giuliovignati/headphone_amplifier/headphone_amplifier board/Headphone_Amp.kicad_pcb

## KiCad design headphone_amplifier board/Headphone_Amp.kicad_pcb (2025-02-23)

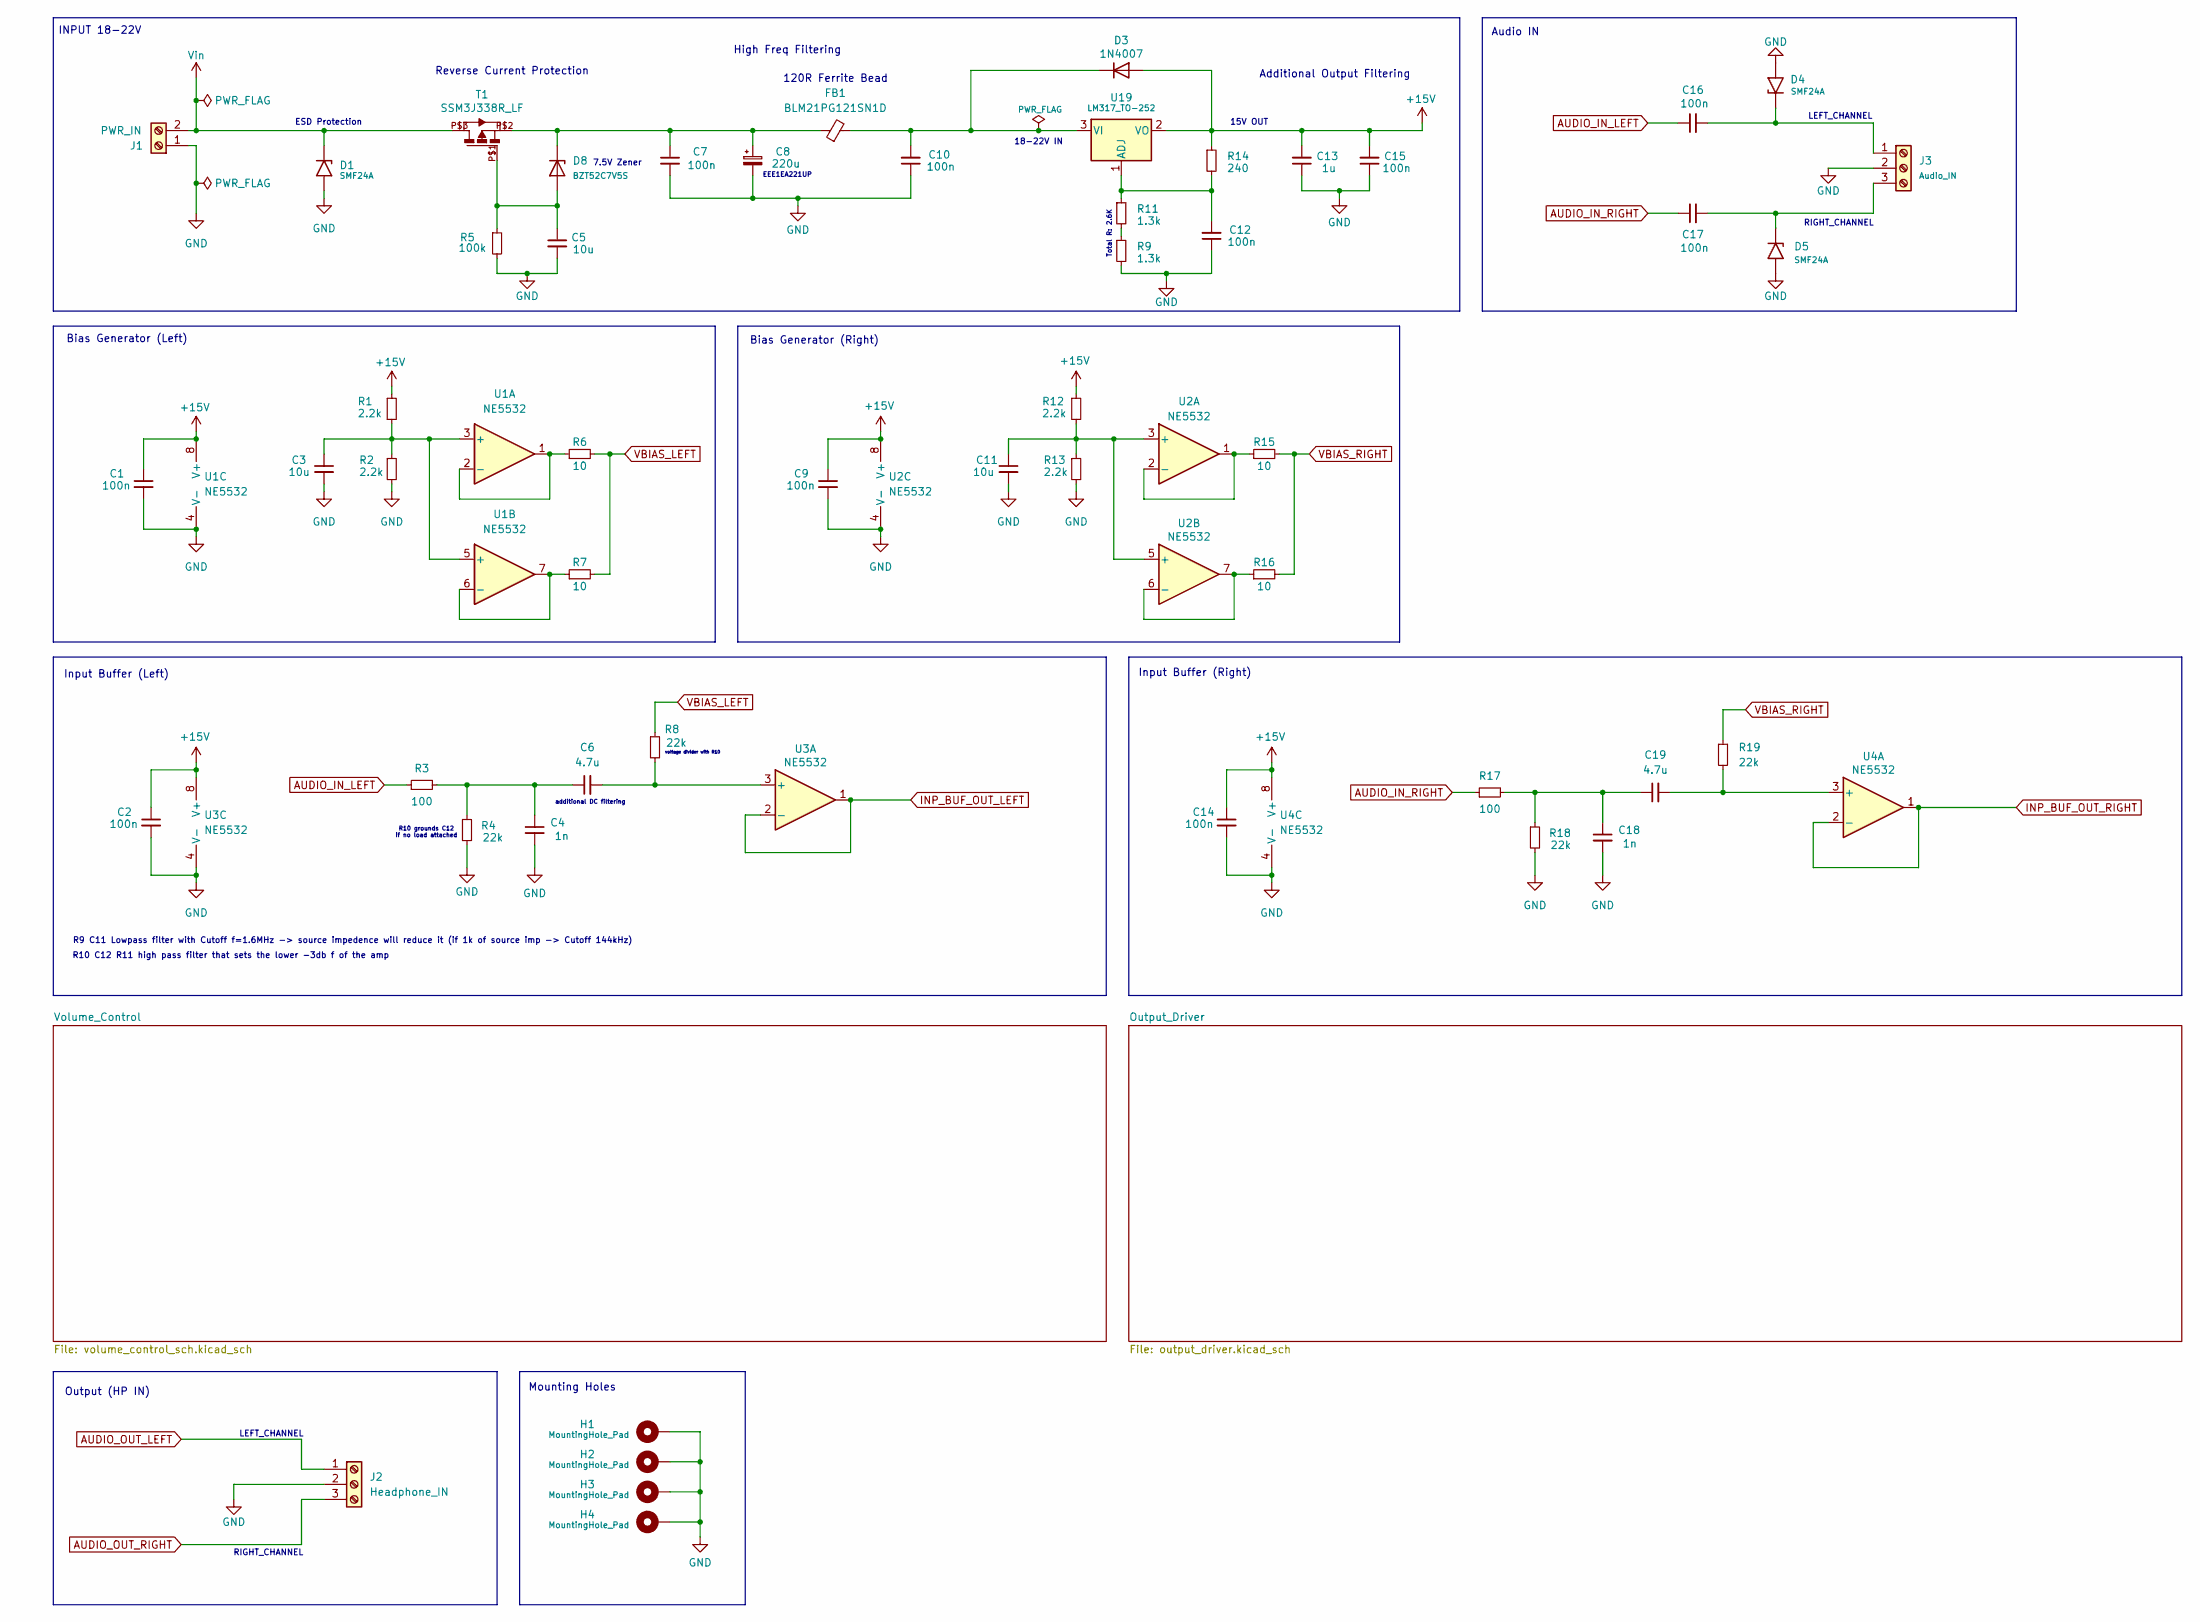
[picture p1: schematic Headphone_Amp.kicad_sch, Headphone Amplifier]

Parts:
C1, C2, C7, C9, C10, C12, C14, C15, C16, C17: 100n; C_0805_2012Metric_Pad1.18x1.45mm_HandSolder
C3, C5, C11: 10u; C_0805_2012Metric_Pad1.18x1.45mm_HandSolder
C4, C18: 1n; C_0805_2012Metric_Pad1.18x1.45mm_HandSolder
C6, C19: 4.7u; C_0805_2012Metric_Pad1.18x1.45mm_HandSolder
C8: 220u; EEE1EA221UP
C13: 1u; C_0805_2012Metric_Pad1.18x1.45mm_HandSolder
D1, D4, D5: SMF24A; D_SOD-123
D3: 1N4007; D_SMA
D8: BZT52C7V5S; D_SOD-123F
FB1: BLM21PG121SN1D; C_0805_2012Metric_Pad1.18x1.45mm_HandSolder
H1, H2, H3, H4: MountingHole_Pad; MountingHole_3.2mm_M3_Pad_Via
J1: PWR_IN; TerminalBlock_bornier-2_P5.08mm
J2: Headphone_IN; TerminalBlock_bornier-3_P5.08mm
J3: Audio_IN; TerminalBlock_bornier-3_P5.08mm
R1, R2, R12, R13: 2.2k; R_0805_2012Metric_Pad1.20x1.40mm_HandSolder
R3, R17: 100; R_0805_2012Metric_Pad1.20x1.40mm_HandSolder
R4, R8, R18, R19: 22k; R_0805_2012Metric_Pad1.20x1.40mm_HandSolder
R5: 100k; R_0805_2012Metric_Pad1.20x1.40mm_HandSolder
R6, R7, R15, R16: 10; R_0805_2012Metric_Pad1.20x1.40mm_HandSolder
R9, R11: 1.3k; R_0805_2012Metric_Pad1.20x1.40mm_HandSolder
R14: 240; R_0805_2012Metric_Pad1.20x1.40mm_HandSolder
T1: SSM3J338R_LF
U1, U2, U3, U4: NE5532; SOIC-8_3.9x4.9mm_P1.27mm
U19: LM317_TO-252; SOT-223

Connections:
+15V: C1.1, C2.1, C9.1, C13.2, C14.1, C15.2, D3.2 (A), R1.1, R12.1, R14.1, U1.8 (V+), U2.8 (V+), U3.8 (V+), U4.8 (V+), U19.2 (VO); also elsewhere on the board
AUDIO_IN_LEFT: C16.1, R3.1
AUDIO_IN_RIGHT: C17.1, R17.1
AUDIO_OUT_LEFT: J2.1; also elsewhere on the board
AUDIO_OUT_RIGHT: J2.3; also elsewhere on the board
GND: C1.2, C2.2, C3.2, C4.2, C5.2, C7.2, C8.2, C9.2, C10.1, C11.2, C12.1, C13.1, C14.2, C15.1, C18.2, D1.2 (A2), D4.2 (A2), D5.2 (A2), H1.1, H2.1, H3.1, H4.1, J1.1, J2.2, J3.2, R2.2, R4.2, R5.2, R9.2, R13.2, R18.2, U1.4 (V-), U2.4 (V-), U3.4 (V-), U4.4 (V-); also elsewhere on the board
INP_BUF_OUT_LEFT: U3.1, U3.2 (-); also elsewhere on the board
INP_BUF_OUT_RIGHT: U4.1, U4.2 (-); also elsewhere on the board
unnamed: C4.1, C6.1, R3.2, R4.1
unnamed: C18.1, C19.1, R17.2, R18.1
unnamed: C10.2, D3.1 (K), FB1.2, U19.3 (VI)
unnamed: C16.2, D4.1 (A1), J3.1
unnamed: C17.2, D5.1 (A1), J3.3
unnamed: C5.1, D8.2 (A), R5.1, T1.P$1
unnamed: C7.1, C8.1, D8.1 (K), FB1.1, T1.P$2
unnamed: R9.1, R11.2
unnamed: C3.1, R1.2, R2.1, U1.3 (+), U1.5 (+)
unnamed: R6.1, U1.1, U1.2 (-)
unnamed: R7.1, U1.6 (-), U1.7
unnamed: C11.1, R12.2, R13.1, U2.3 (+), U2.5 (+)
unnamed: R15.1, U2.1, U2.2 (-)
unnamed: R16.1, U2.6 (-), U2.7
unnamed: C6.2, R8.2, U3.3 (+)
unnamed: C19.2, R19.2, U4.3 (+)
unnamed: C12.2, R11.1, R14.2, U19.1 (ADJ)
VBIAS_LEFT: R6.2, R7.2, R8.1; also elsewhere on the board
VBIAS_RIGHT: R15.2, R16.2, R19.1; also elsewhere on the board
Vin: D1.1 (A1), J1.2, T1.P$3

Notes on the sheet:
Audio IN
120R Ferrite Bead
15V OUT
ESD Protection
7.5V Zener
R10 C12 R11 high pass filter that sets the lower -3db f of the amp
Total R: 2.6K
Bias Generator (Right)
Mounting Holes
Input Buffer (Right)
High Freq Filtering
Output (HP IN)
EEE1EA221UP
Reverse Current Protection
RIGHT_CHANNEL
Bias Generator (Left)
LEFT_CHANNEL
INPUT 18-22V
R10 grounds C12 if no load attached
18-22V IN
Additional Output Filtering
R9 C11 Lowpass filter with Cutoff f=1.6MHz -> source impedence will reduce it (if 1k of source imp -> Cutoff 144kHz)
Input Buffer (Left)
voltage divider with R10
additional DC filtering

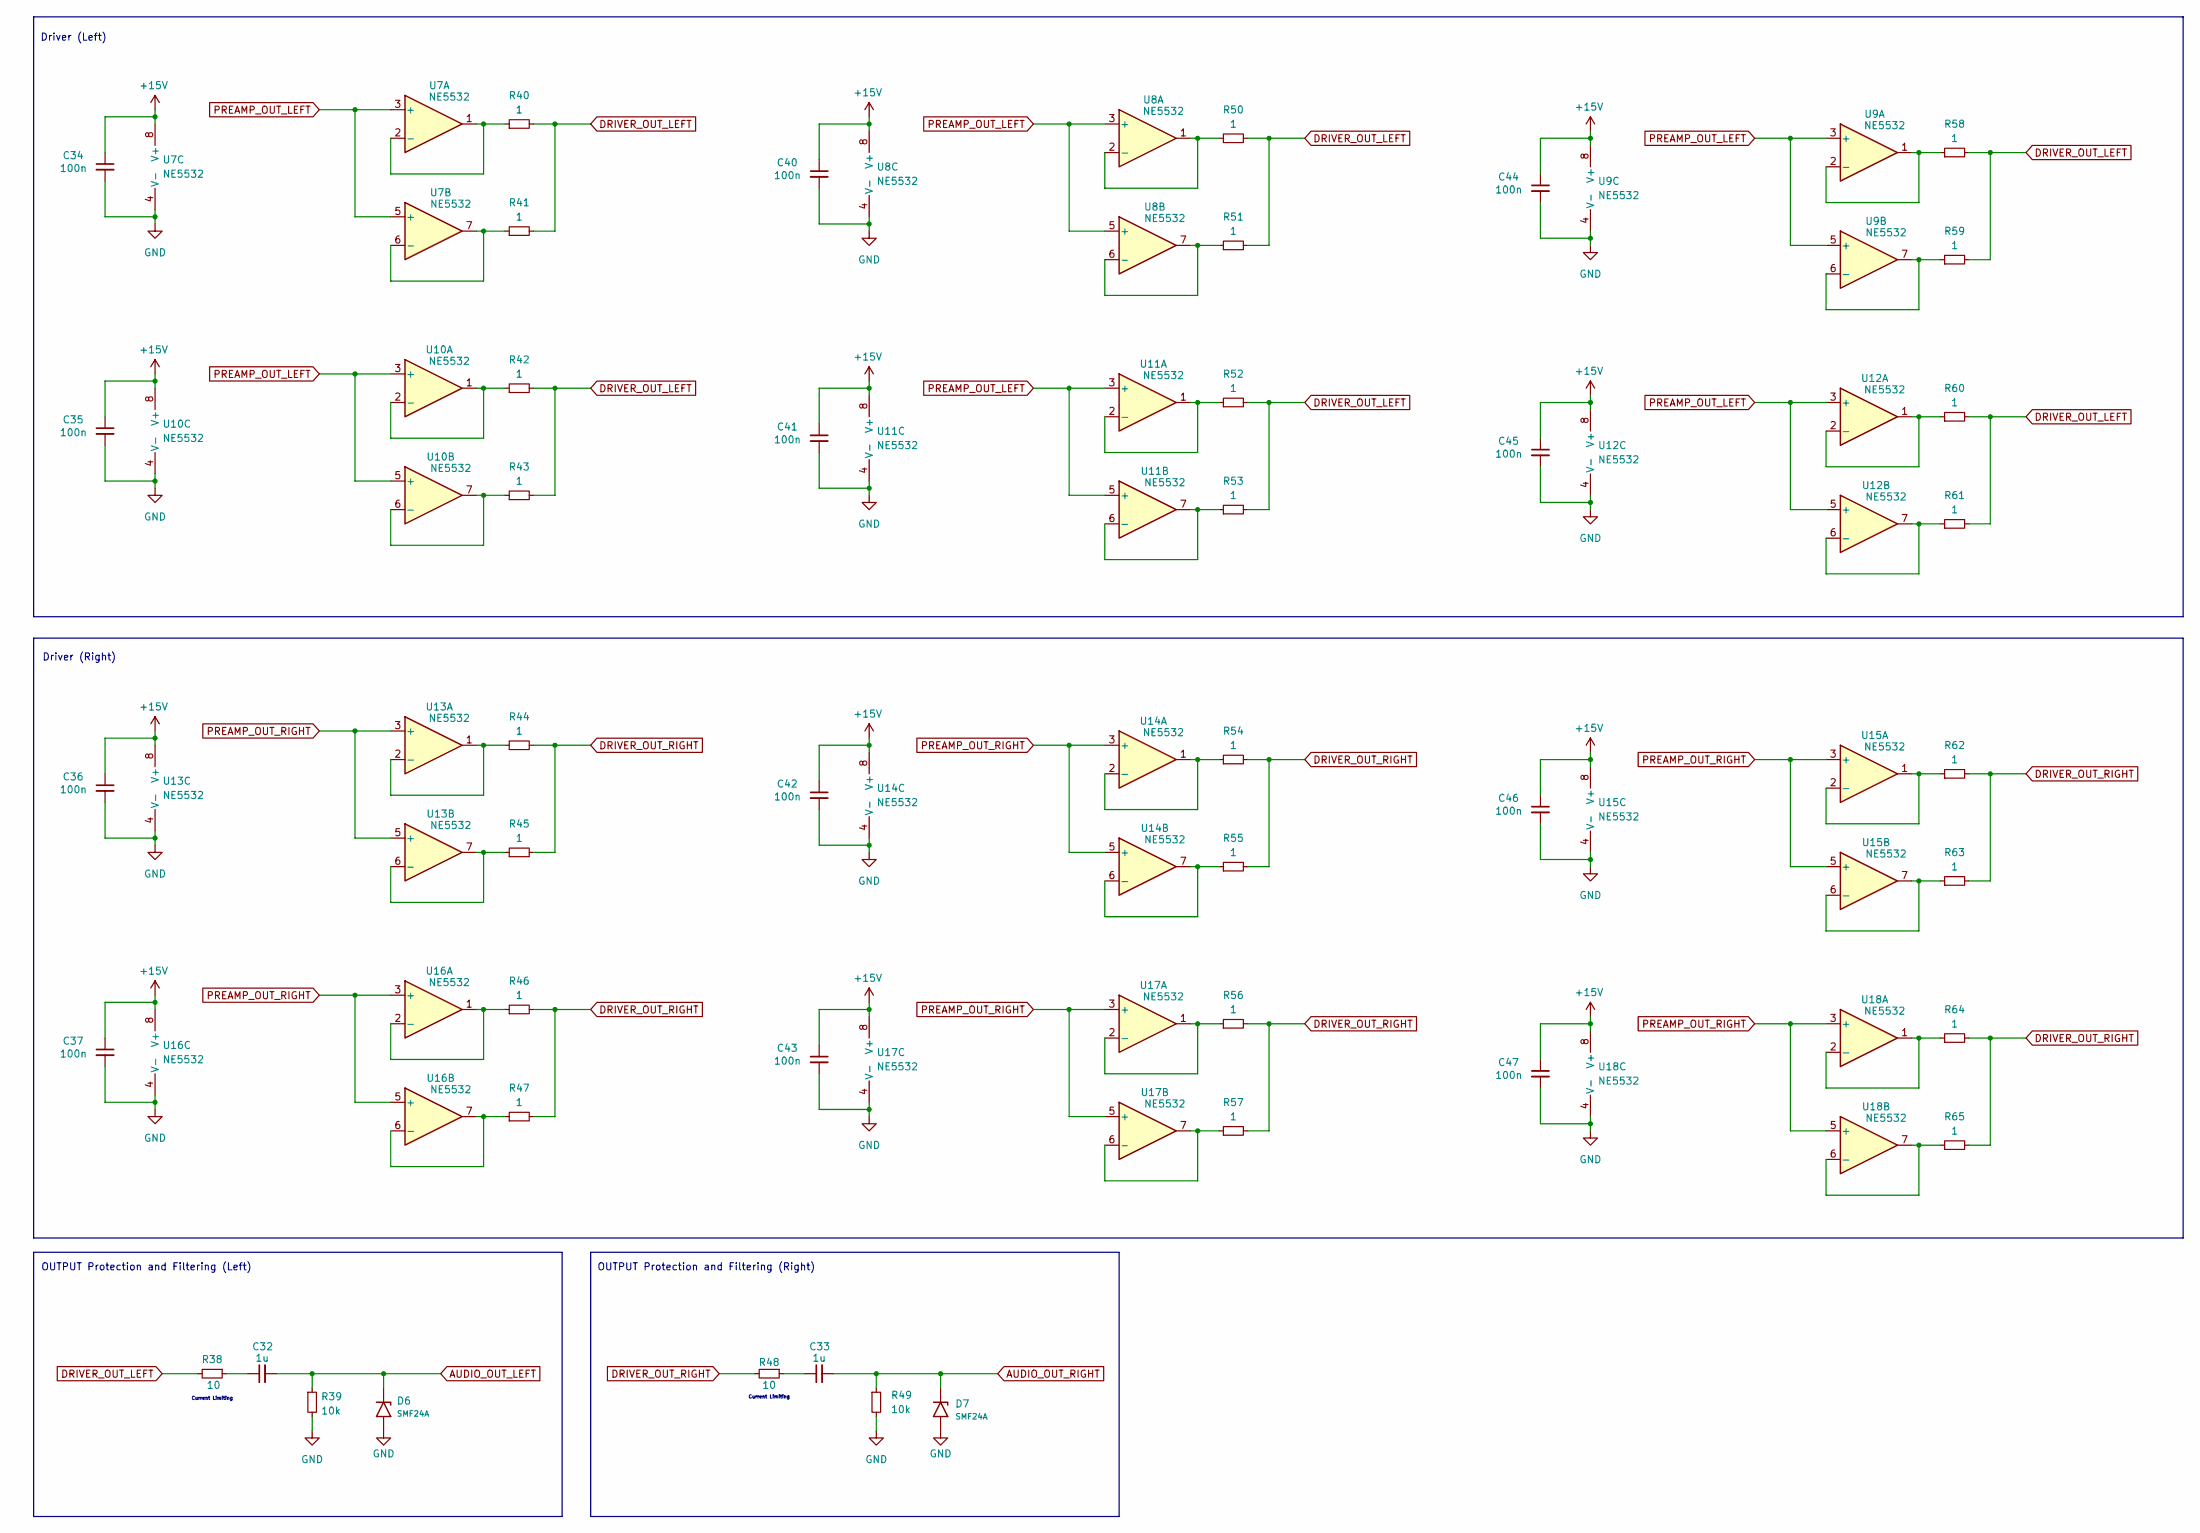
[picture p2: schematic output_driver.kicad_sch, Output Driver Stage]

Parts:
C32, C33: 1u; C_Rect_L18.0mm_W7.0mm_P15.00mm_FKS3_FKP3
C34, C35, C36, C37, C40, C41, C42, C43, C44, C45, C46, C47: 100n; C_0805_2012Metric_Pad1.18x1.45mm_HandSolder
D6, D7: SMF24A; D_SOD-123
R38, R48: 10; R_0805_2012Metric_Pad1.20x1.40mm_HandSolder
R39, R49: 10k; R_0805_2012Metric_Pad1.20x1.40mm_HandSolder
R40, R41, R42, R43, R44, R45, R46, R47, R50, R51, R52, R53, R54, R55, R56, R57, R58, R59, R60, R61, R62, R63, R64, R65: 1; R_0805_2012Metric_Pad1.20x1.40mm_HandSolder
U7, U8, U9, U10, U11, U12, U13, U14, U15, U16, U17, U18: NE5532; SOIC-8_3.9x4.9mm_P1.27mm

Connections:
+15V: C34.1, C35.1, C36.1, C37.1, C40.1, C41.1, C42.1, C43.1, C44.1, C45.1, C46.1, C47.1, U7.8 (V+), U8.8 (V+), U9.8 (V+), U10.8 (V+), U11.8 (V+), U12.8 (V+), U13.8 (V+), U14.8 (V+), U15.8 (V+), U16.8 (V+), U17.8 (V+), U18.8 (V+); also elsewhere on the board
AUDIO_OUT_LEFT: C32.2, D6.1 (A1), R39.1; also elsewhere on the board
AUDIO_OUT_RIGHT: C33.2, D7.1 (A1), R49.1; also elsewhere on the board
DRIVER_OUT_LEFT: R38.2, R40.2, R41.2, R42.2, R43.2, R50.2, R51.2, R52.2, R53.2, R58.2, R59.2, R60.2, R61.2
DRIVER_OUT_RIGHT: R44.2, R45.2, R46.2, R47.2, R48.2, R54.2, R55.2, R56.2, R57.2, R62.2, R63.2, R64.2, R65.2
GND: C34.2, C35.2, C36.2, C37.2, C40.2, C41.2, C42.2, C43.2, C44.2, C45.2, C46.2, C47.2, D6.2 (A2), D7.2 (A2), R39.2, R49.2, U7.4 (V-), U8.4 (V-), U9.4 (V-), U10.4 (V-), U11.4 (V-), U12.4 (V-), U13.4 (V-), U14.4 (V-), U15.4 (V-), U16.4 (V-), U17.4 (V-), U18.4 (V-); also elsewhere on the board
unnamed: C32.1, R38.1
unnamed: C33.1, R48.1
unnamed: R40.1, U7.1, U7.2 (-)
unnamed: R41.1, U7.6 (-), U7.7
unnamed: R50.1, U8.1, U8.2 (-)
unnamed: R51.1, U8.6 (-), U8.7
unnamed: R58.1, U9.1, U9.2 (-)
unnamed: R59.1, U9.6 (-), U9.7
unnamed: R42.1, U10.1, U10.2 (-)
unnamed: R43.1, U10.6 (-), U10.7
unnamed: R52.1, U11.1, U11.2 (-)
unnamed: R53.1, U11.6 (-), U11.7
unnamed: R60.1, U12.1, U12.2 (-)
unnamed: R61.1, U12.6 (-), U12.7
unnamed: R44.1, U13.1, U13.2 (-)
unnamed: R45.1, U13.6 (-), U13.7
unnamed: R54.1, U14.1, U14.2 (-)
unnamed: R55.1, U14.6 (-), U14.7
unnamed: R62.1, U15.1, U15.2 (-)
unnamed: R63.1, U15.6 (-), U15.7
unnamed: R46.1, U16.1, U16.2 (-)
unnamed: R47.1, U16.6 (-), U16.7
unnamed: R56.1, U17.1, U17.2 (-)
unnamed: R57.1, U17.6 (-), U17.7
unnamed: R64.1, U18.1, U18.2 (-)
unnamed: R65.1, U18.6 (-), U18.7
PREAMP_OUT_LEFT: U7.3 (+), U7.5 (+), U8.3 (+), U8.5 (+), U9.3 (+), U9.5 (+), U10.3 (+), U10.5 (+), U11.3 (+), U11.5 (+), U12.3 (+), U12.5 (+); also elsewhere on the board
PREAMP_OUT_RIGHT: U13.3 (+), U13.5 (+), U14.3 (+), U14.5 (+), U15.3 (+), U15.5 (+), U16.3 (+), U16.5 (+), U17.3 (+), U17.5 (+), U18.3 (+), U18.5 (+); also elsewhere on the board

Notes on the sheet:
Driver (Left)
Current Limiting
Driver (Right)
OUTPUT Protection and Filtering (Right)
OUTPUT Protection and Filtering (Left)

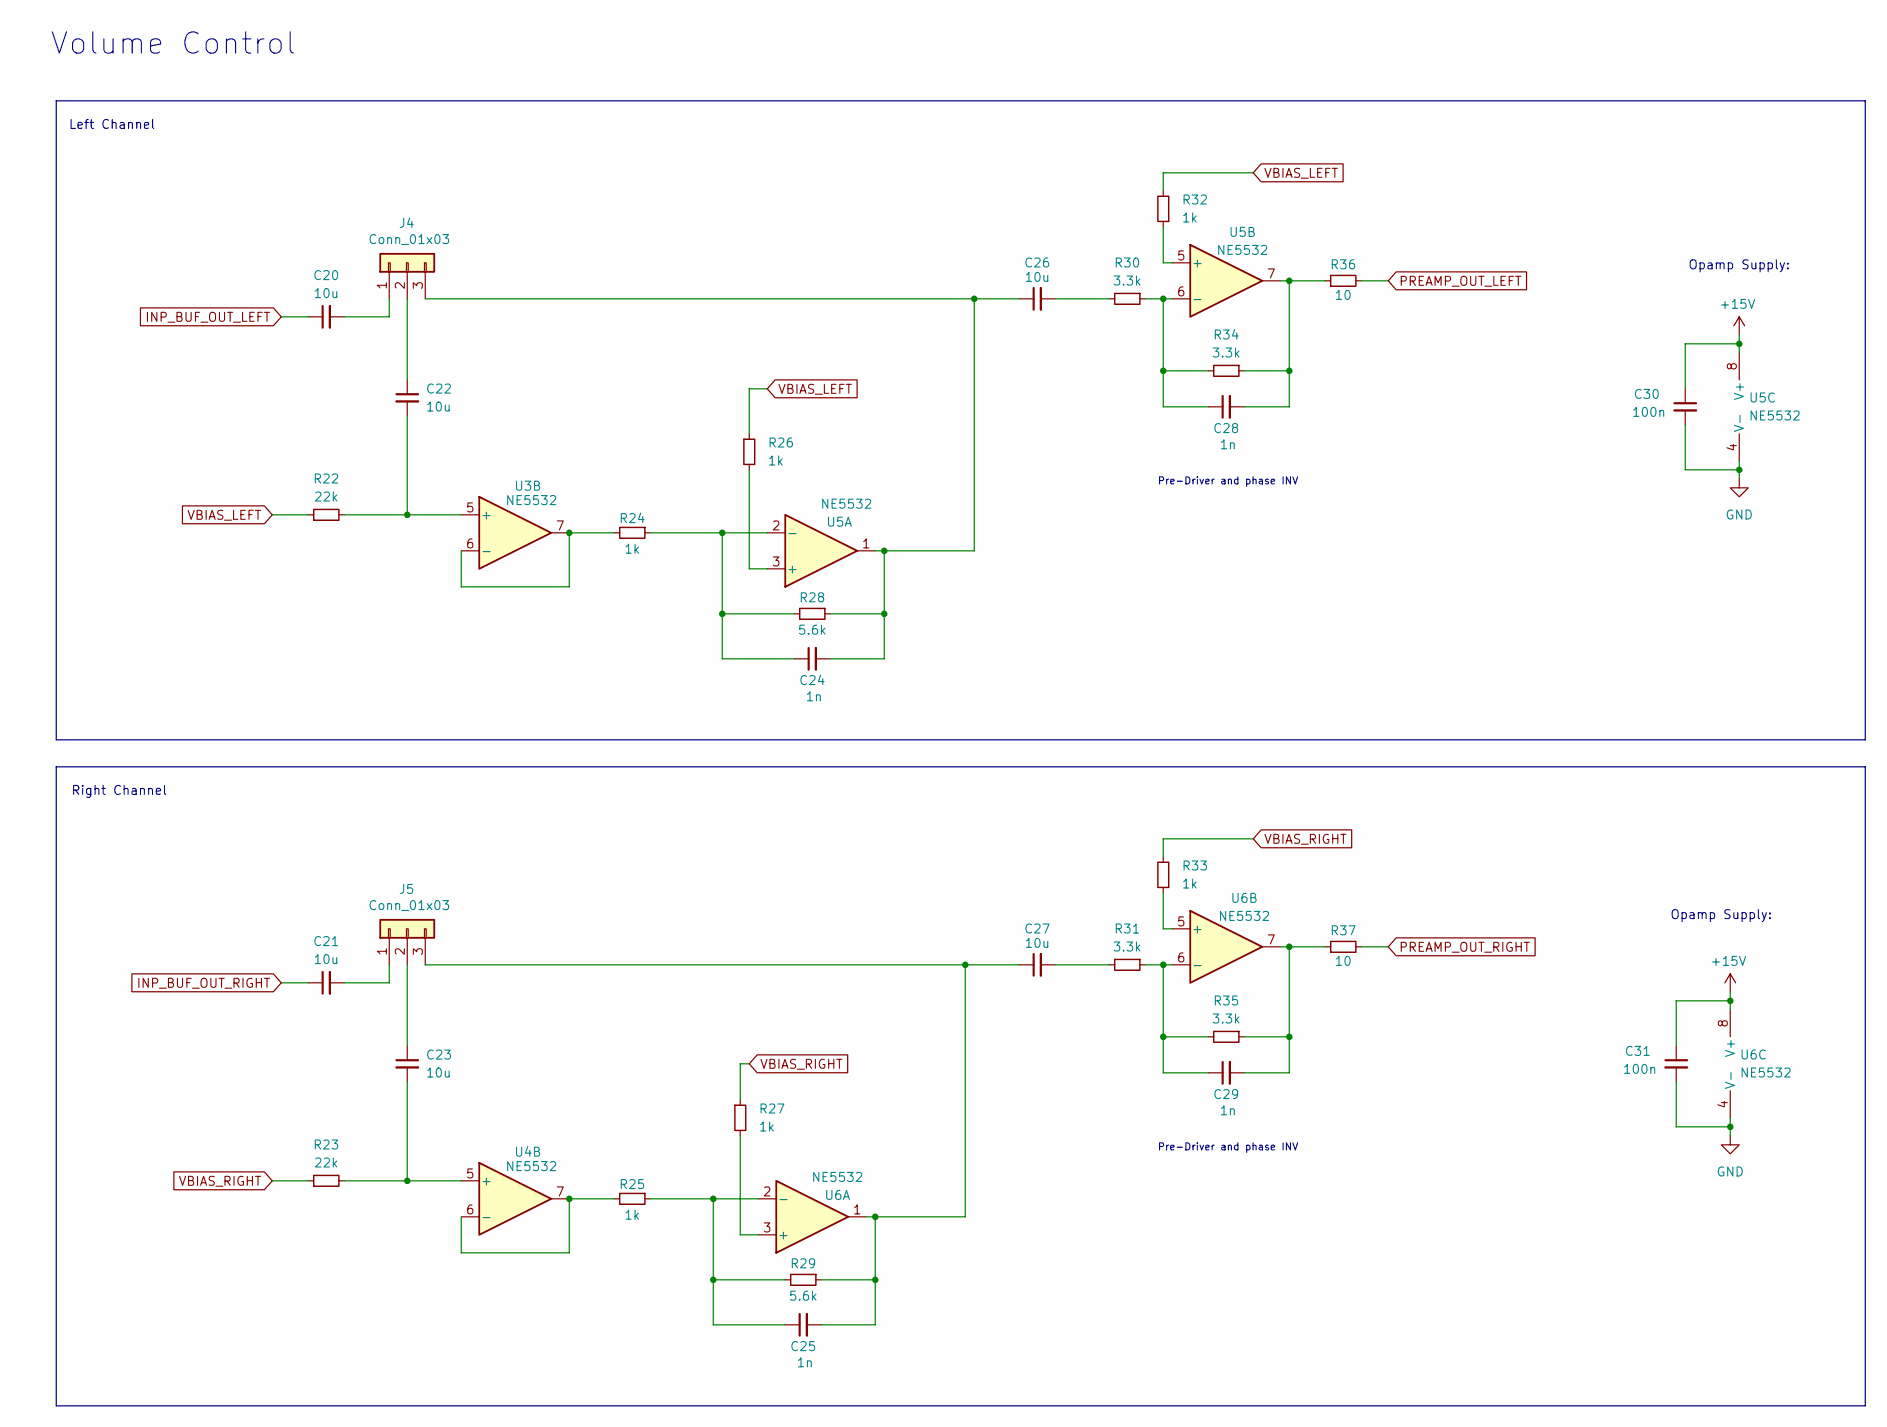
[picture p3: schematic volume_control_sch.kicad_sch, Baxandaal Volume Control Stage]

Parts:
C20, C21, C22, C23, C26, C27: 10u; C_0805_2012Metric_Pad1.18x1.45mm_HandSolder
C24, C25, C28, C29: 1n; C_0805_2012Metric_Pad1.18x1.45mm_HandSolder
C30, C31: 100n; C_0805_2012Metric_Pad1.18x1.45mm_HandSolder
J4, J5: Conn_01x03; PinHeader_1x03_P2.54mm_Vertical
R22, R23: 22k; R_0805_2012Metric_Pad1.20x1.40mm_HandSolder
R24, R25, R26, R27, R32, R33: 1k; R_0805_2012Metric_Pad1.20x1.40mm_HandSolder
R28, R29: 5.6k; R_0805_2012Metric_Pad1.20x1.40mm_HandSolder
R30, R31, R34, R35: 3.3k; R_0805_2012Metric_Pad1.20x1.40mm_HandSolder
R36, R37: 10; R_0805_2012Metric_Pad1.20x1.40mm_HandSolder
U3, U4, U5, U6: NE5532; SOIC-8_3.9x4.9mm_P1.27mm

Connections:
+15V: C30.1, C31.1, U5.8 (V+), U6.8 (V+); also elsewhere on the board
GND: C30.2, C31.2, U5.4 (V-), U6.4 (V-); also elsewhere on the board
INP_BUF_OUT_LEFT: C20.1; also elsewhere on the board
INP_BUF_OUT_RIGHT: C21.1; also elsewhere on the board
unnamed: C26.2, R30.2
unnamed: C27.2, R31.2
unnamed: C28.2, R34.1, R36.1, U5.7
unnamed: C29.2, R35.1, R37.1, U6.7
unnamed: C20.2, J4.1
unnamed: C22.1, J4.2
unnamed: C24.2, C26.1, J4.3, R28.1, U5.1
unnamed: C21.2, J5.1
unnamed: C23.1, J5.2
unnamed: C25.2, C27.1, J5.3, R29.1, U6.1
unnamed: C22.2, R22.2, U3.5 (+)
unnamed: R24.2, U3.6 (-), U3.7
unnamed: C23.2, R23.2, U4.5 (+)
unnamed: R25.2, U4.6 (-), U4.7
unnamed: R26.2, U5.3 (+)
unnamed: C24.1, R24.1, R28.2, U5.2 (-)
unnamed: R32.1, U5.5 (+)
unnamed: C28.1, R30.1, R34.2, U5.6 (-)
unnamed: R27.2, U6.3 (+)
unnamed: C25.1, R25.1, R29.2, U6.2 (-)
unnamed: R33.1, U6.5 (+)
unnamed: C29.1, R31.1, R35.2, U6.6 (-)
PREAMP_OUT_LEFT: R36.2; also elsewhere on the board
PREAMP_OUT_RIGHT: R37.2; also elsewhere on the board
VBIAS_LEFT: R22.1, R26.1, R32.2; also elsewhere on the board
VBIAS_RIGHT: R23.1, R27.1, R33.2; also elsewhere on the board

Notes on the sheet:
Left Channel
Opamp Supply:
Right Channel
Pre-Driver and phase INV
Volume Control

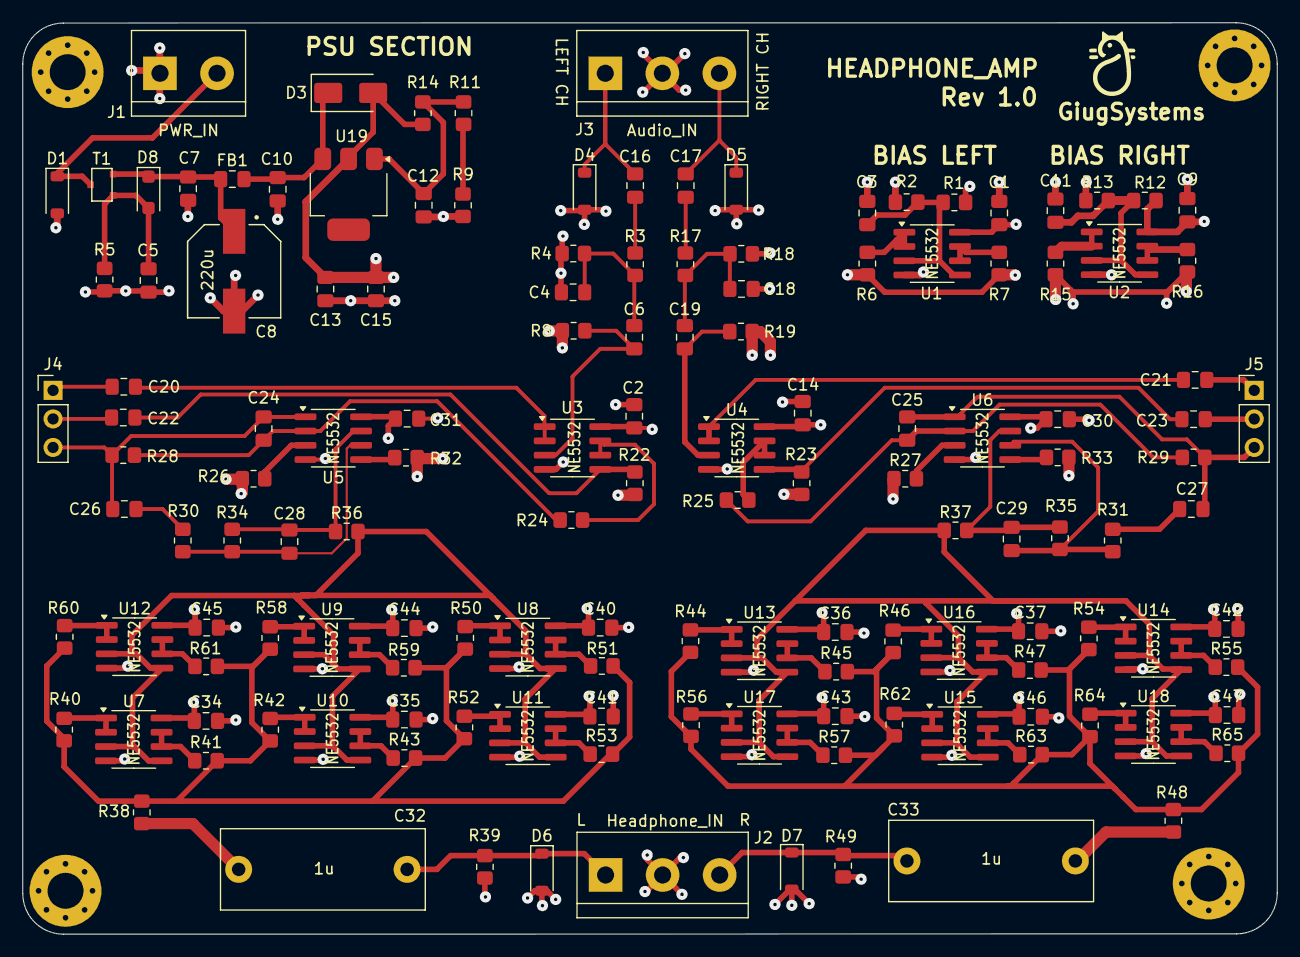
[picture p4: board Headphone_Amp.kicad_pcb from above]

Board: 4 copper layers, 111.7 x 81.2 mm, 144 parts (0 on the bottom side), 80 nets.
