giuliovignati/headphone_amplifier/(commit log)

2024-12-22 first ver
    [Headphone_Amp.kicad_pcb, Headphone_Amp.kicad_sch, output_driver.kicad_sch, volume_control_sch.kicad_sch]
2024-12-30 Bug Fix
    [Headphone_Amp.kicad_pcb]
2025-02-15 updated routing
    [Headphone_Amp.kicad_pcb]
2025-02-23 revisited bias plane
    [Headphone_Amp.kicad_pcb, Headphone_Amp.kicad_sch, output_driver.kicad_sch, volume_control_sch.kicad_sch]
